bulme-internetradio/Internetradio-Resources/3D Prints/Front.stl

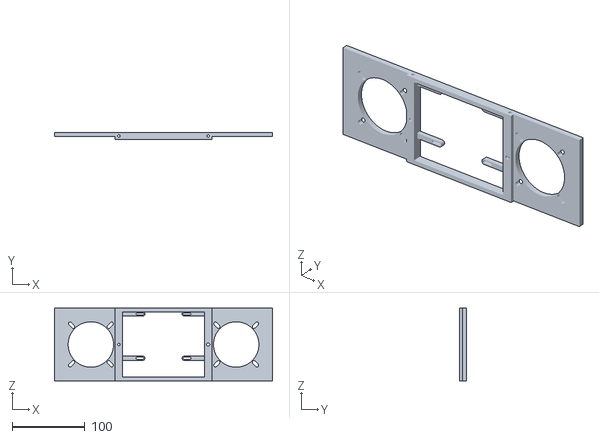
[picture p1: CAD file, 2021-04-21]
3D Prints/Front.stl
300.0 x 10.0 x 100.0
