bulme-internetradio/Internetradio-Resources/Lasern_Case.dxf

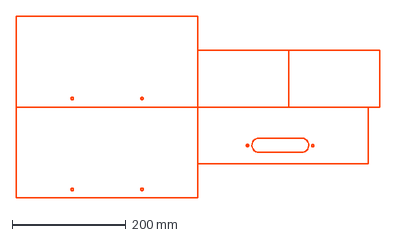
[picture p2: CAD file, 2021-04-21]
Lasern_Case.dxf
640.0 x 320.0 mm
