bulme-internetradio/Internetradio-Resources/3D Prints/Front_1.stl

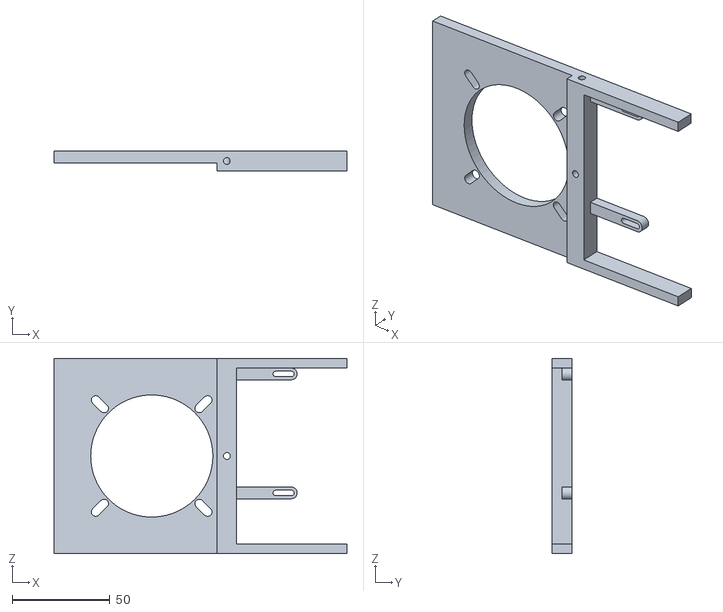
[picture p3: CAD file, 2021-04-21]
3D Prints/Front_1.stl
150.0 x 10.0 x 100.0
