bulme-internetradio/Internetradio-Resources/(list of files, cad)

Other CAD files:
3D Prints/Front_2.stl
