bulme-internetradio/Internetradio-Resources/Plan_Case.pdf

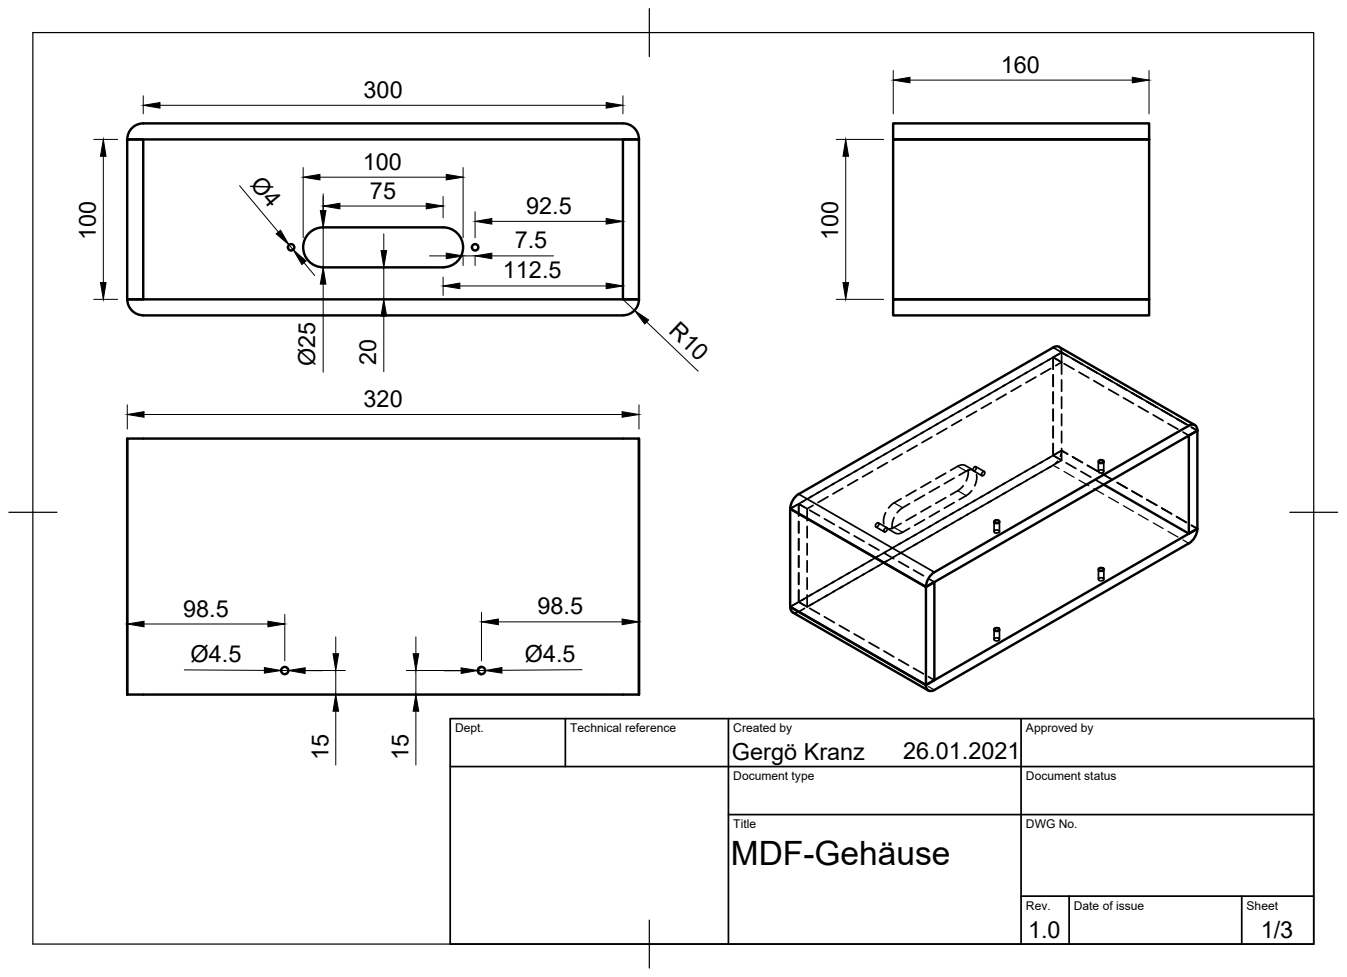
[picture p4: page 1]

Dept. | Technical reference | Created by Gergö Kranz 26.01.2021 | Approved by

Document type | Document status

Title MDF-Gehäuse | DWG No.

Rev. | Date of issue | Sheet

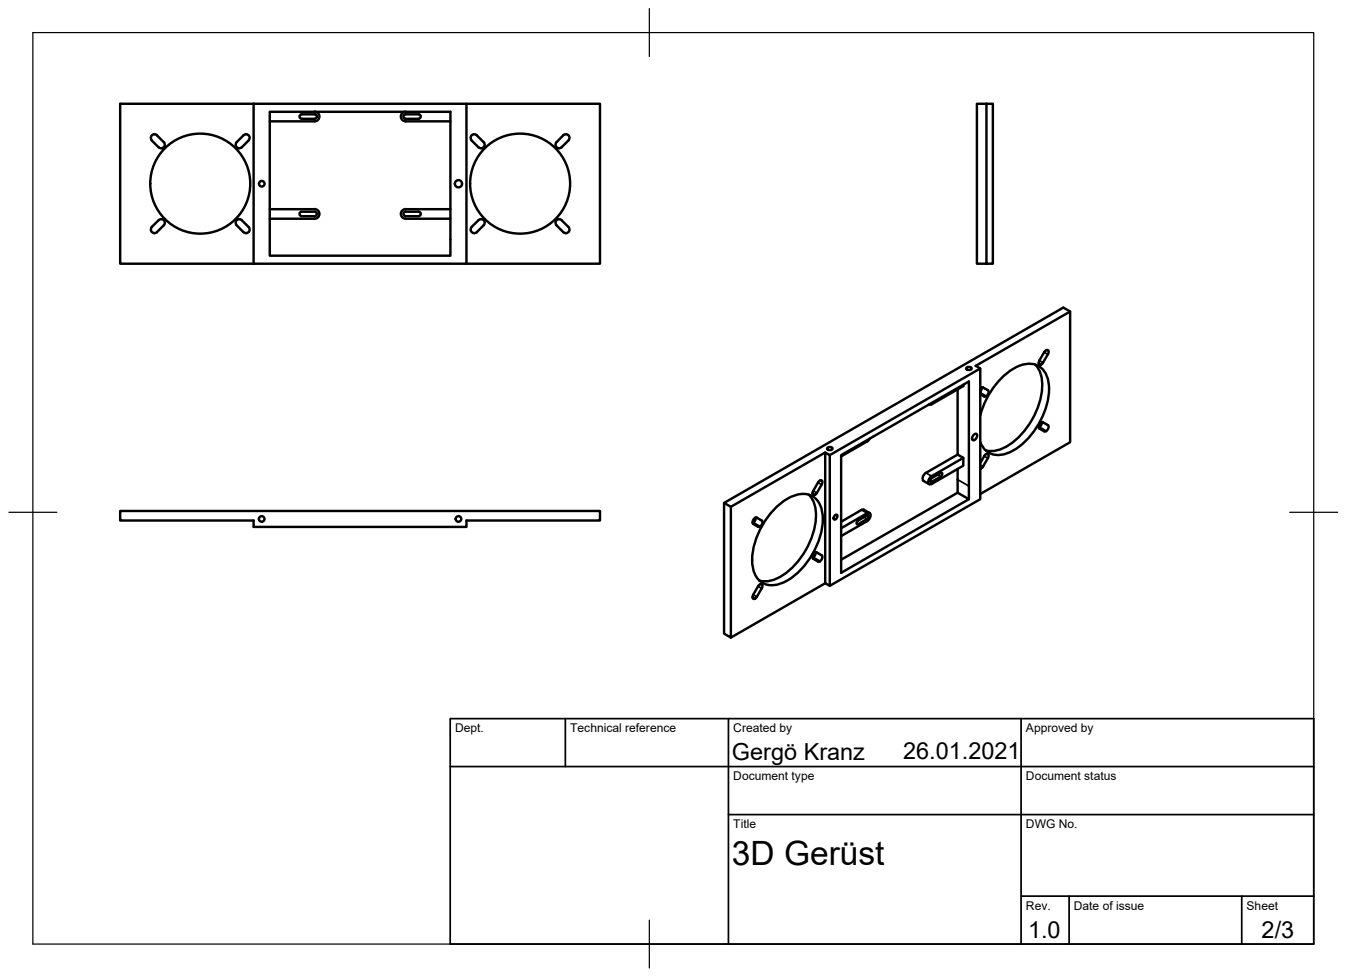
[picture p5: page 2]

Dept. | Technical reference | Created by Gergö Kranz 26.01.2021 | Approved by

Document type | Document status

Title 3D Gerüst | DWG No.

Rev. | Date of issue | Sheet

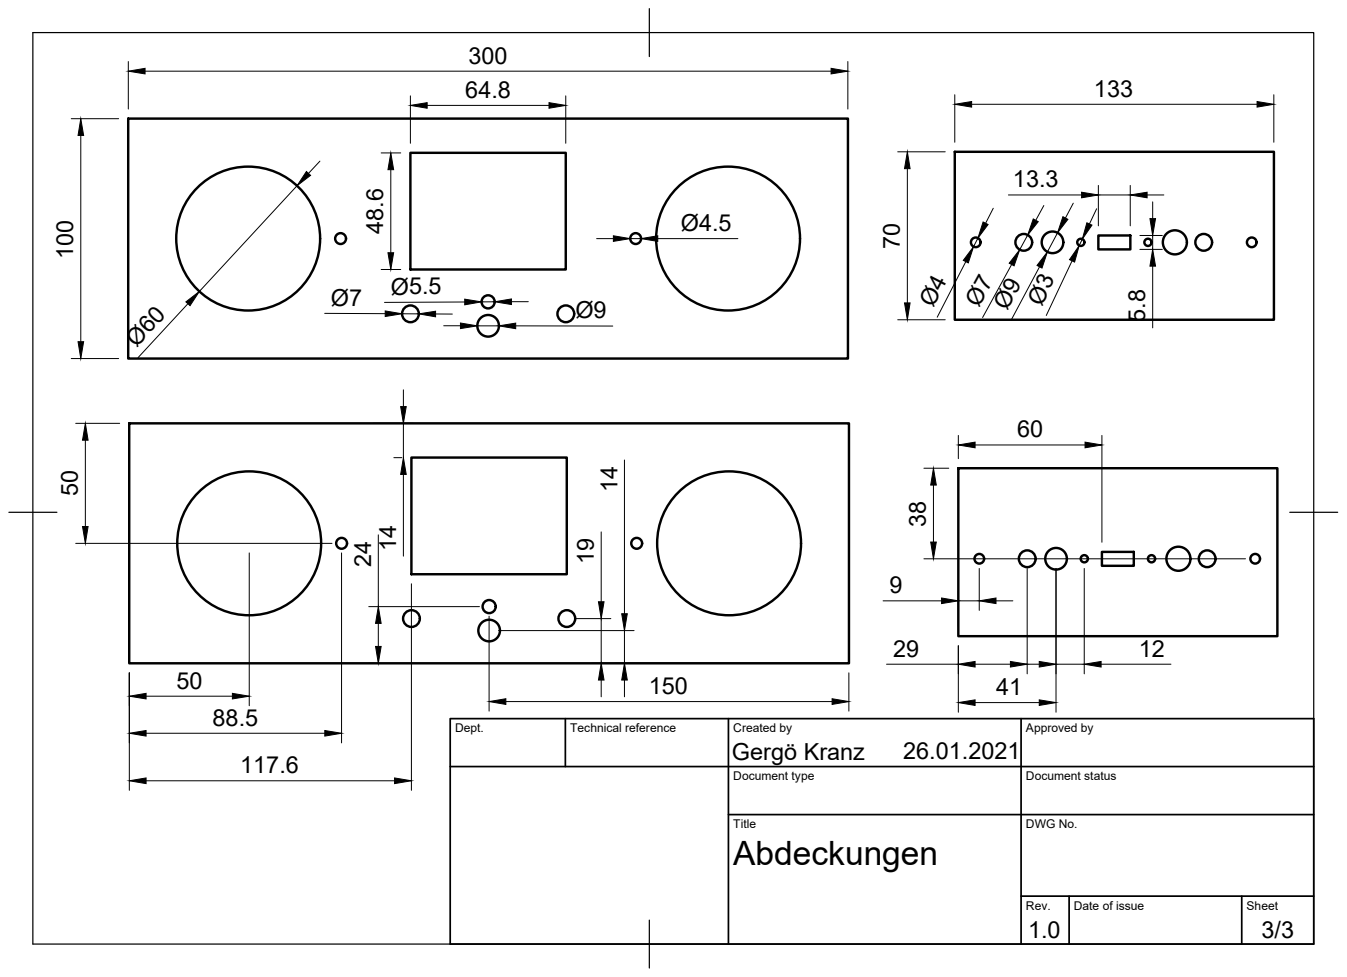
[picture p6: page 3]

Dept. | Technical reference | Created by Gergö Kranz 26.01.2021 | Approved by

Document type | Document status

Title Abdeckungen | DWG No.

Rev. | Date of issue | Sheet
