bulme-internetradio/Internetradio-Resources/Eagle-Files_V1.1/Schematic_IR _1.1.brd

## EAGLE design Eagle-Files_V1.1/Schematic_IR _1.1.brd (2021-04-21)

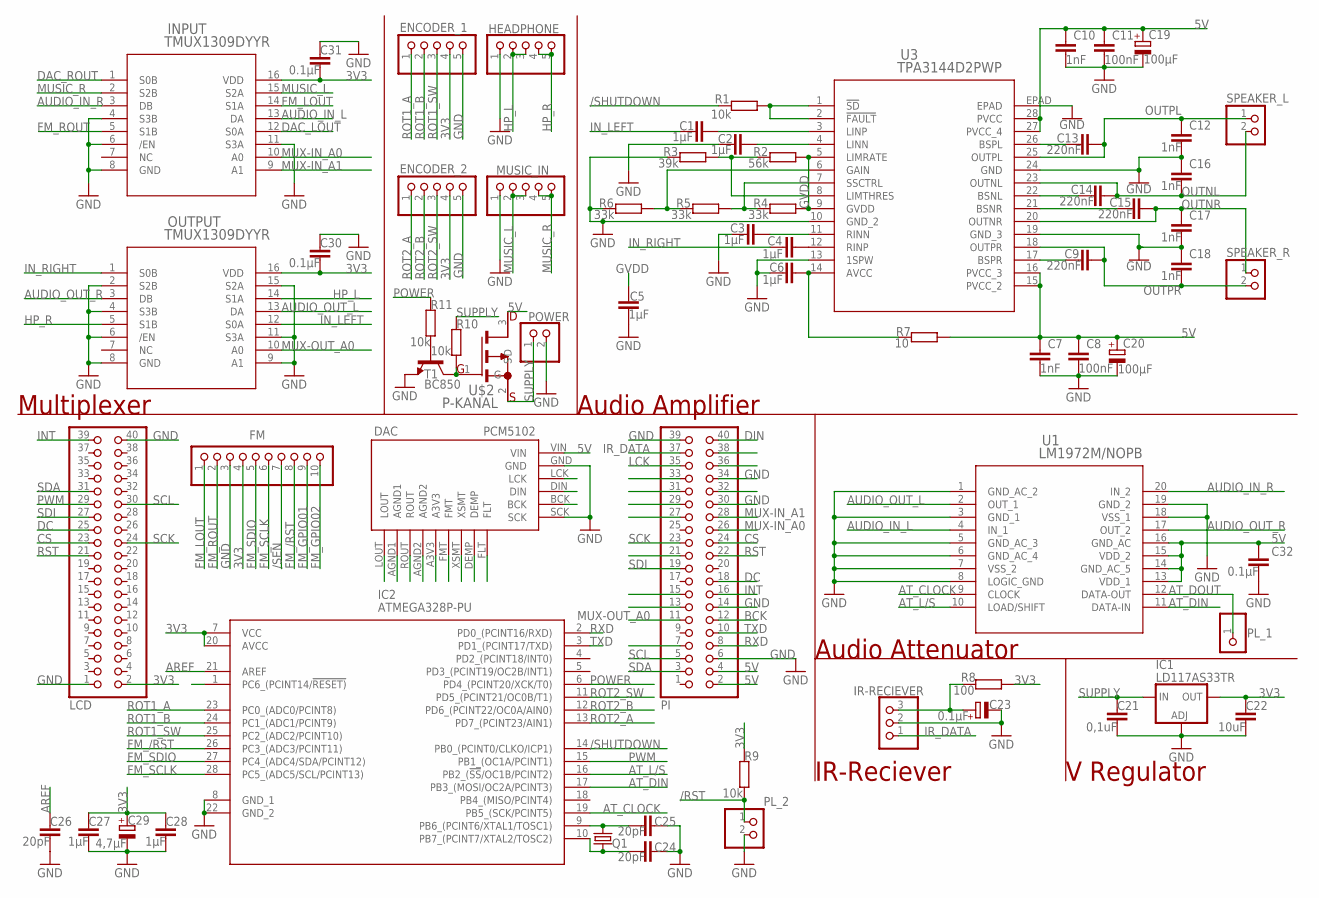
[picture p7: schematic Schematic_IR _1.1.sch]

Parts:
C1, C2, C3, C4, C5, C6, C27, C28: 1µF; C0603K
C7, C10, C12, C16, C17, C18: 1nF; C0603K
C8, C11: 100nF; C0603K
C9, C13, C14, C15: 220nF; C0603K
C19, C20: 100µF; SMC_B
C21: 0,1uF; C0603K
C22: 10uF; C0603K
C23: 0.1µF; SMC_B
C24, C25, C26: 20pF; C0603K
C29: 4,7µF; SMC_B
C30, C31, C32: 0.1µF; C0603K
DAC: PCM5102
ENCODER_1, ENCODER_2: PINHD-1X5; 1X05
FM: PINHD-1X10_2.54; 1X10
HEADPHONE: PINHD-1X5_2.54; 1X05
IC1: LD117AS33TR; SOT223
IC2: ATMEGA328P-PU; DIP794W53P254L3467H457Q28N
INPUT: TMUX1309DYYR; SOIC_309DYYR_TEX
IR-RECIEVER: PINHD-1X3_2.54; 1X03
LCD: PINHD-2X20; 2X20
MUSIC_IN: PINHD-1X5_2.54; 1X05
OUTPUT: TMUX1309DYYR; SOIC_309DYYR_TEX
PI: PINHD-2X20; 2X20
PL_1: PINHD-1X1_2.00; 1X01M
PL_2: PINHD-1X2_2.00; 1X02M
POWER: PINHD-1X2_2.54; 1X02
Q1: KX-KS; 11.4X4.5
R1, R9, R10, R11: 10k; R0603
R2: 56k; R0603
R3: 39k; R0603
R4, R5, R6: 33k; R0603
R7: 10; R0603
R8: 100; R0603
SPEAKER_L: PINHD-1X2_2.54; 1X02
SPEAKER_R: PINHD-1X2_2.54; 1X02
T1: BC850; SOT23
U1: LM1972M/NOPB; M20B_TEX
U3: TPA3144D2PWP; PWP28_2P4X3.4_TEX
U$2: P-KANAL; SOT23

Connections:
3V3: C22.2, C27.1, C28.1, C29.+, C30.2, C31.2, ENCODER_1.4, ENCODER_2.4, FM.4, IC1.4 (OUT), IC2.7 (VCC), IC2.20 (AVCC), INPUT.16 (VDD), LCD.2, OUTPUT.16 (VDD), R8.2, R9.2
5V: C7.1, C8.1, C10.1, C11.1, C19.+, C20.+, C32.1, DAC.VIN, PI.2, PI.4, R7.2, U1.13 (VDD_1), U1.14 (GND_AC_5), U1.15 (VDD_2), U1.16 (GND_AC), U3.15 (PVCC_2), U3.16 (PVCC_3), U3.27 (PVCC_4), U3.28 (PVCC), U$2.3 (D)
/RST: IC2.1 (PC6_(PCINT14/!RESET)), PL_2.1, R9.1
/SEN: FM.7
/SHUTDOWN: IC2.14 (PB0_(PCINT0/CLKO/ICP1)), R1.1
AREF: C26.1, IC2.21 (AREF)
AT_CLOCK: IC2.19 (PB5_(SCK/PCINT5)), U1.9 (CLOCK)
AT_DIN: IC2.17 (PB3_(MOSI/OC2A/PCINT3)), U1.11 (DATA-IN)
AT_DOUT: PL_1.1, U1.12 (DATA-OUT)
AT_L/S: IC2.16 (PB2_(!SS!/OC1B/PCINT2)), U1.10 (LOAD/SHIFT)
AUDIO_IN_L: INPUT.13 (DA), U1.4 (IN_1)
AUDIO_IN_R: INPUT.3 (DB), U1.20 (IN_2)
AUDIO_OUT_L: OUTPUT.13 (DA), U1.2 (OUT_1)
AUDIO_OUT_R: OUTPUT.3 (DB), U1.17 (OUT_2)
BCK: DAC.BCK, PI.12
CS: LCD.23, PI.24
DAC_LOUT: DAC.LOUT, INPUT.12 (S0A)
DAC_ROUT: DAC.ROUT, INPUT.1 (S0B)
DC: LCD.25, PI.18
DIN: DAC.DIN, PI.40
FM_/RST: FM.8, IC2.26 (PC3_(ADC3/PCINT11))
FM_GPIO01: FM.9
FM_GPIO02: FM.10
FM_LOUT: FM.1, INPUT.14 (S1A)
FM_ROUT: FM.2, INPUT.5 (S1B)
FM_SCLK: FM.6, IC2.28 (PC5_(ADC5/SCL/PCINT13))
FM_SDIO: FM.5, IC2.27 (PC4_(ADC4/SDA/PCINT12))
GND: C2.1, C3.1, C5.2, C6.1, C7.2, C8.2, C10.2, C11.2, C12.2, C16.1, C17.2, C18.1, C19.-, C20.-, C21.1, C22.1, C23.-, C24.1, C25.1, C26.2, C27.2, C28.2, C29.-, C30.1, C31.1, C32.2, DAC.GND, DAC.SCK, ENCODER_1.5, ENCODER_2.5, FM.3, HEADPHONE.1, IC1.1 (ADJ), IC2.8 (GND_1), IC2.22 (GND_2), INPUT.4 (S3B), INPUT.6 (/EN), INPUT.8 (GND), INPUT.11 (S3A), IR-RECIEVER.2, LCD.1, LCD.40, MUSIC_IN.1, OUTPUT.2 (S2B), OUTPUT.4 (S3B), OUTPUT.6 (/EN), OUTPUT.8 (GND), OUTPUT.9 (A1), OUTPUT.11 (S3A), OUTPUT.15 (S2A), PI.6, PI.14, PI.30, PI.34, PI.39, PL_2.2, POWER.2, R3.1, R6.1, T1.2 (E), U1.1 (GND_AC_2), U1.3 (GND_1), U1.5 (GND_AC_3), U1.6 (GND_AC_4), U1.7 (VSS_2), U1.8 (LOGIC_GND), U1.18 (VSS_1), U1.19 (GND_2), U3.10 (GND_2), U3.13 (1SPW), U3.19 (GND_3), U3.24 (GND), U3.EPAD
GVDD: C5.1, R2.2, R4.2, U3.5 (LIMRATE), U3.9 (GVDD)
HP_L: HEADPHONE.2, HEADPHONE.3, OUTPUT.14 (S1A)
HP_R: HEADPHONE.4, HEADPHONE.5, OUTPUT.5 (S1B)
INT: LCD.39, PI.16
IN_LEFT: C1.1, OUTPUT.12 (S0A)
IN_RIGHT: C4.1, OUTPUT.1 (S0B)
IR_DATA: IR-RECIEVER.1, PI.37
LCK: DAC.LCK, PI.35
MUSIC_L: INPUT.15 (S2A), MUSIC_IN.2, MUSIC_IN.3
MUSIC_R: INPUT.2 (S2B), MUSIC_IN.4, MUSIC_IN.5
MUX-IN_A0: INPUT.10 (A0), PI.26
MUX-IN_A1: INPUT.9 (A1), PI.28
MUX-OUT_A0: OUTPUT.10 (A0), PI.11
unnamed: R1.2, U3.1 (!SD), U3.2 (!FAULT)
unnamed: C4.2, U3.12 (RINP)
unnamed: R11.2, T1.1 (B)
unnamed: R4.1, R5.2, U3.7 (SSCTRL)
unnamed: R2.1, R3.2, U3.8 (LIMTHRES)
unnamed: R5.1, R6.2, U3.6 (GAIN)
unnamed: C6.2, R7.1, U3.14 (AVCC)
unnamed: R10.1, T1.3 (C), U$2.1 (G)
unnamed: C24.2, IC2.10 (PB7_(PCINT7/XTAL2/TOSC2)), Q1.1
unnamed: C25.2, IC2.9 (PB6_(PCINT6/XTAL1/TOSC1)), Q1.2
unnamed: C1.2, U3.3 (LINP)
unnamed: C2.2, U3.4 (LINN)
unnamed: C13.1, U3.26 (BSPL)
unnamed: C23.+, IR-RECIEVER.3, R8.1
unnamed: C3.2, U3.11 (RINN)
unnamed: C14.1, U3.22 (BSNL)
unnamed: C15.1, U3.21 (BSNR)
unnamed: C9.1, U3.17 (BSPR)
OUTNL: C14.2, C16.2, SPEAKER_L.2, U3.23 (OUTNL)
OUTNR: C15.2, C17.1, SPEAKER_R.1, U3.20 (OUTNR)
OUTPL: C12.1, C13.2, SPEAKER_L.1, U3.25 (OUTPL)
OUTPR: C9.2, C18.2, SPEAKER_R.2, U3.18 (OUTPR)
POWER: IC2.6 (PD4_(PCINT20/XCK/T0)), R11.1
PWM: IC2.15 (PB1_(OC1A/PCINT1)), LCD.29
ROT1_A: ENCODER_1.1, IC2.23 (PC0_(ADC0/PCINT8))
ROT1_B: ENCODER_1.2, IC2.24 (PC1_(ADC1/PCINT9))
ROT1_SW: ENCODER_1.3, IC2.25 (PC2_(ADC2/PCINT10))
ROT2_A: ENCODER_2.1, IC2.13 (PD7_(PCINT23/AIN1))
ROT2_B: ENCODER_2.2, IC2.12 (PD6_(PCINT22/OC0A/AIN0))
ROT2_SW: ENCODER_2.3, IC2.11 (PD5_(PCINT21/OC0B/T1))
RST: LCD.21, PI.22
RXD: IC2.2 (PD0_(PCINT16/RXD)), PI.8
SCK: LCD.24, PI.23
SCL: LCD.30, PI.5
SDA: LCD.31, PI.3
SDI: LCD.27, PI.19
SUPPLY: C21.2, IC1.3 (IN), POWER.1, R10.2, U$2.2 (S)
TXD: IC2.3 (PD1_(PCINT17/TXD)), PI.10

Notes on the sheet:
Multiplexer
Audio Amplifier
Audio Attenuator
V Regulator
IR-Reciever

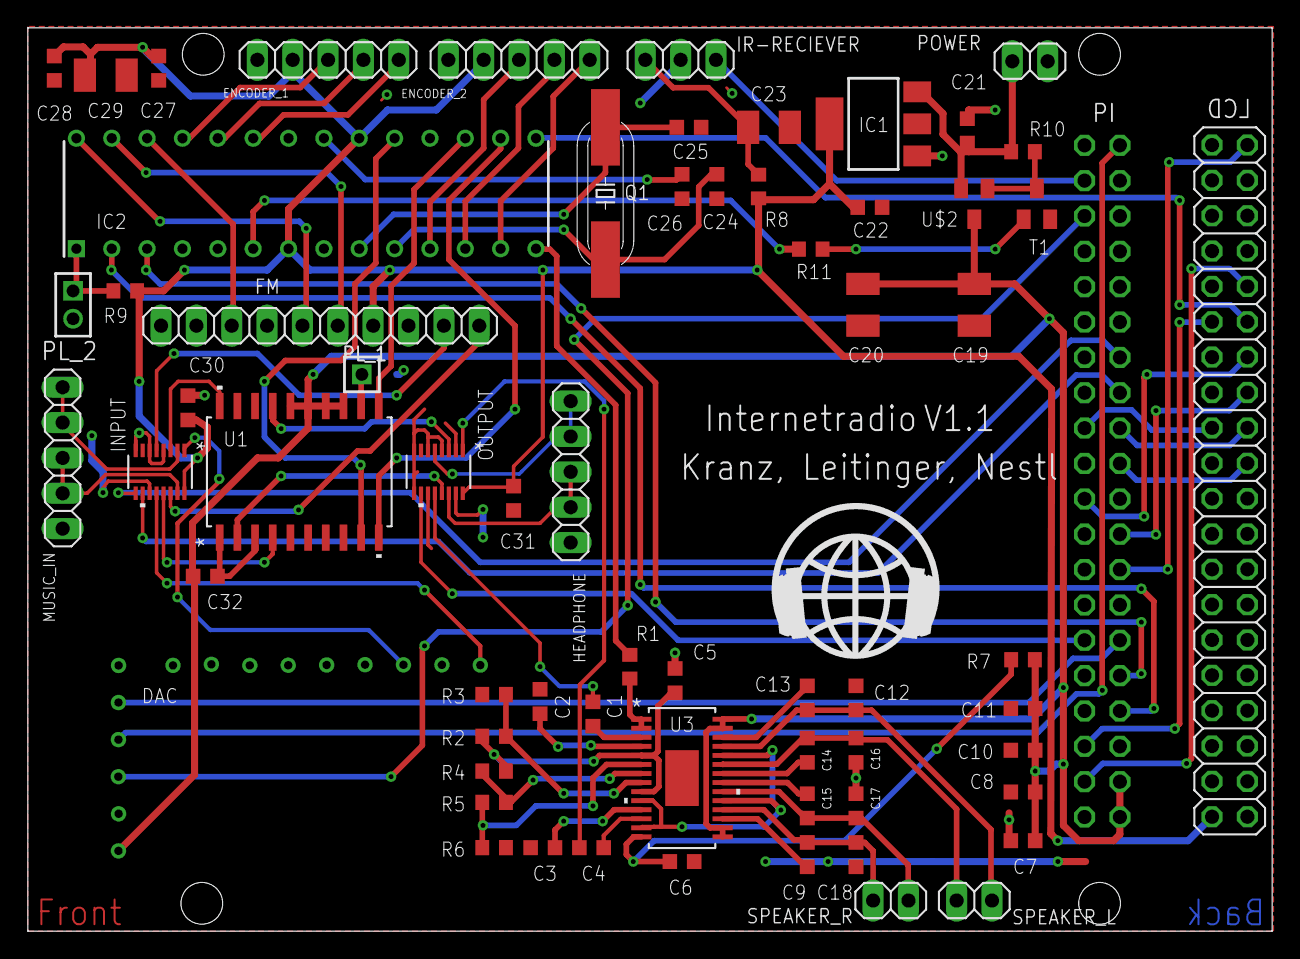
[picture p8: board Schematic_IR _1.1.brd from above]

Board: 2 copper layers, 89.4 x 64.9 mm, 67 parts (1 on the bottom side), 76 nets.

Other parts of the board:
U$1: LOGO
