bulme-internetradio/Internetradio-Resources/(commit log)

2021-04-21 reorganised files
    [Front.stl, Front_1.stl, Front_2.stl, Schematic_IR _1.1.brd, Schematic_IR _1.1.sch]
2021-04-21 reorganised again
    [Front.stl, Front_1.stl, Front_2.stl, Schematic_IR _1.1.brd, Schematic_IR _1.1.sch]
2021-04-21 added new files
    [Covers.dxf]
2021-04-21 added file to laser
    [Lasern.dxf]
