bulme-internetradio/Internetradio-Resources/(notices)

Notices in the files:
parts and their libraries:
Fancy_InternetRadio: COPYRIGHT: Copyright (C) 2018 Accelerated Designs. All rights reserved
crystal-geyer_V1_0: Copyright: Geyer-Electronic
